ZephyrCloudNine/kinematic_outfits/README.md

# kinematic_dress_hw_fw
Project files for custom "kinematic" dress that uses servos to move parts of it in a wavy motion.
Firmware uses an ESP32-C3 Devkit module.
Servos used - SG90 along with PCA9685 servo driver to extend servo drive functionality.
Mechanical design done on Fusion 360.
