ZephyrCloudNine/kinematic_outfits/hardware/stm32_servo_controller/production/stm32_servo_controller_pcb_BOM_final.xlsx

Designator | Footprint | Quantity | Value | LCSC Part # | JLC assembly type
C1, C10, C11, C18, C21, C22, C5, C6, C7, C9 | 603 | 10 | 100nF | C14663 | Basic
C12, C13 | 1206 | 2 | 22uF | C12891 | Basic
C14, C15, C2, C8 | 603 | 4 | 1uF | C15849 | Basic
C16 | 805 | 1 | 10uF | C15850 | Basic
C17, C19, C20 | 805 | 3 | 22uF | C45783 | Basic
C3, C4 | 603 | 2 | 20pF | C325469 | Basic
D1, D4 | 603 | 2 | LED_ORANGE | C2286 | Basic
D2, D5 | 603 | 2 | LED_GREEN | C2290 | Basic
D3 | D_SMB | 1 | SS54 | C22452 | Basic
F1 | 1206 | 1 | Polyfuse | C516068 | Extended
FB1 | 805 | 1 | FerriteBead | C79382 | Extended
J3 | GCT_USB4105GFA120 | 1 | USB4105GFA120 | C2988369 | Extended
L1 | L_Sunlord_MWSA0503S | 1 | 6.8uH | C177249 | Extended
L2 | L_Sunlord_MWSA0503S | 1 | 2.2uH | C177247 | Extended
Q1 | SOT-23 | 1 | AO3415A | C133233 | Extended
R1, R2, R20, R28, R3, R4, R8, R9 | 603 | 8 | 10K | C25804 | Basic
R10, R14, R15, R5 | 603 | 4 | 5.1K | C23186 | Basic
R11 | 603 | 1 | 1.5K | C22843 | Basic
R12, R13, R19, R21, R23 | 603 | 5 | 100R | C22775 | Basic
R17 | 603 | 1 | 110K | C25805 | Extended
R18 | 603 | 1 | 15K | C22809 | Basic
R22 | 603 | 1 | 51K | C23196 | Basic
R25, R26 | 603 | 2 | 1K | C21190 | Basic
R27 | 805 | 1 | 0.5R | C28319 | Basic
R6, R7 | 603 | 2 | 22R | C23345 | Basic
U1 | LQFP-48_7x7mm_P0.5mm | 1 | STM32F103C8Tx | C8734 | Extended
U2 | SOT-23-6 | 1 | USBLC6-2SC6 | C5180249 | Extended
U3 | SOT-23-6 | 1 | MT3608B | C19189893 | Extended
U4 | SOT-23-5 | 1 | LP5907MFX-3.3/NOPB | C80670 | Extended
U5 | HSOP-8-1EP_3.9x4.9mm_P1.27mm_EP2.3x2.3mm | 1 | IP2312 | C605433 | Extended
U6 | SOT-23-6 | 1 | DW01 | C227441 | Extended
U7 | TSSOP-8_4.4x3mm_P0.65mm | 1 | HL 8205A | C7499846 | Extended
U8 | TSSOP-20_4.4x6.5mm_P0.65mm | 1 | TXS0108EPW | C17206 | Extended
Y1 | Crystal_HC49-4H | 1 | 8MHz | C21263 | Extended
