ZephyrCloudNine/kinematic_outfits/hardware/stm32_servo_controller/3dmodels/USB4105GFA120.step

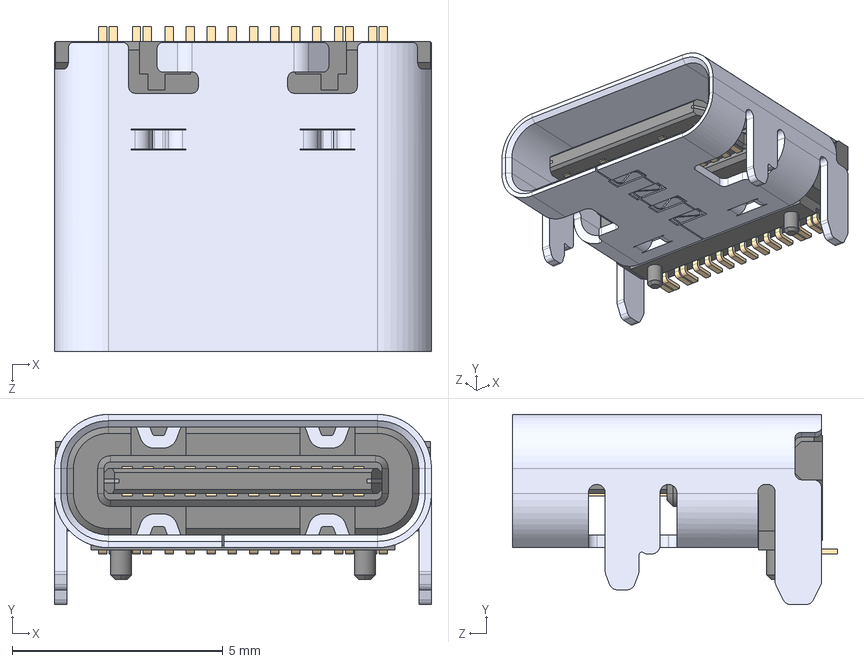
[picture p1: CAD file, 2024-10-18]
hardware/stm32_servo_controller/3dmodels/USB4105GFA120.step
8.94 x 4.51 x 7.71 mm
