ZephyrCloudNine/kinematic_outfits/hardware/stm32_servo_controller/stm32_servo_controller.kicad_pcb

## KiCad design hardware/stm32_servo_controller/stm32_servo_controller.kicad_pcb (2024-11-01)

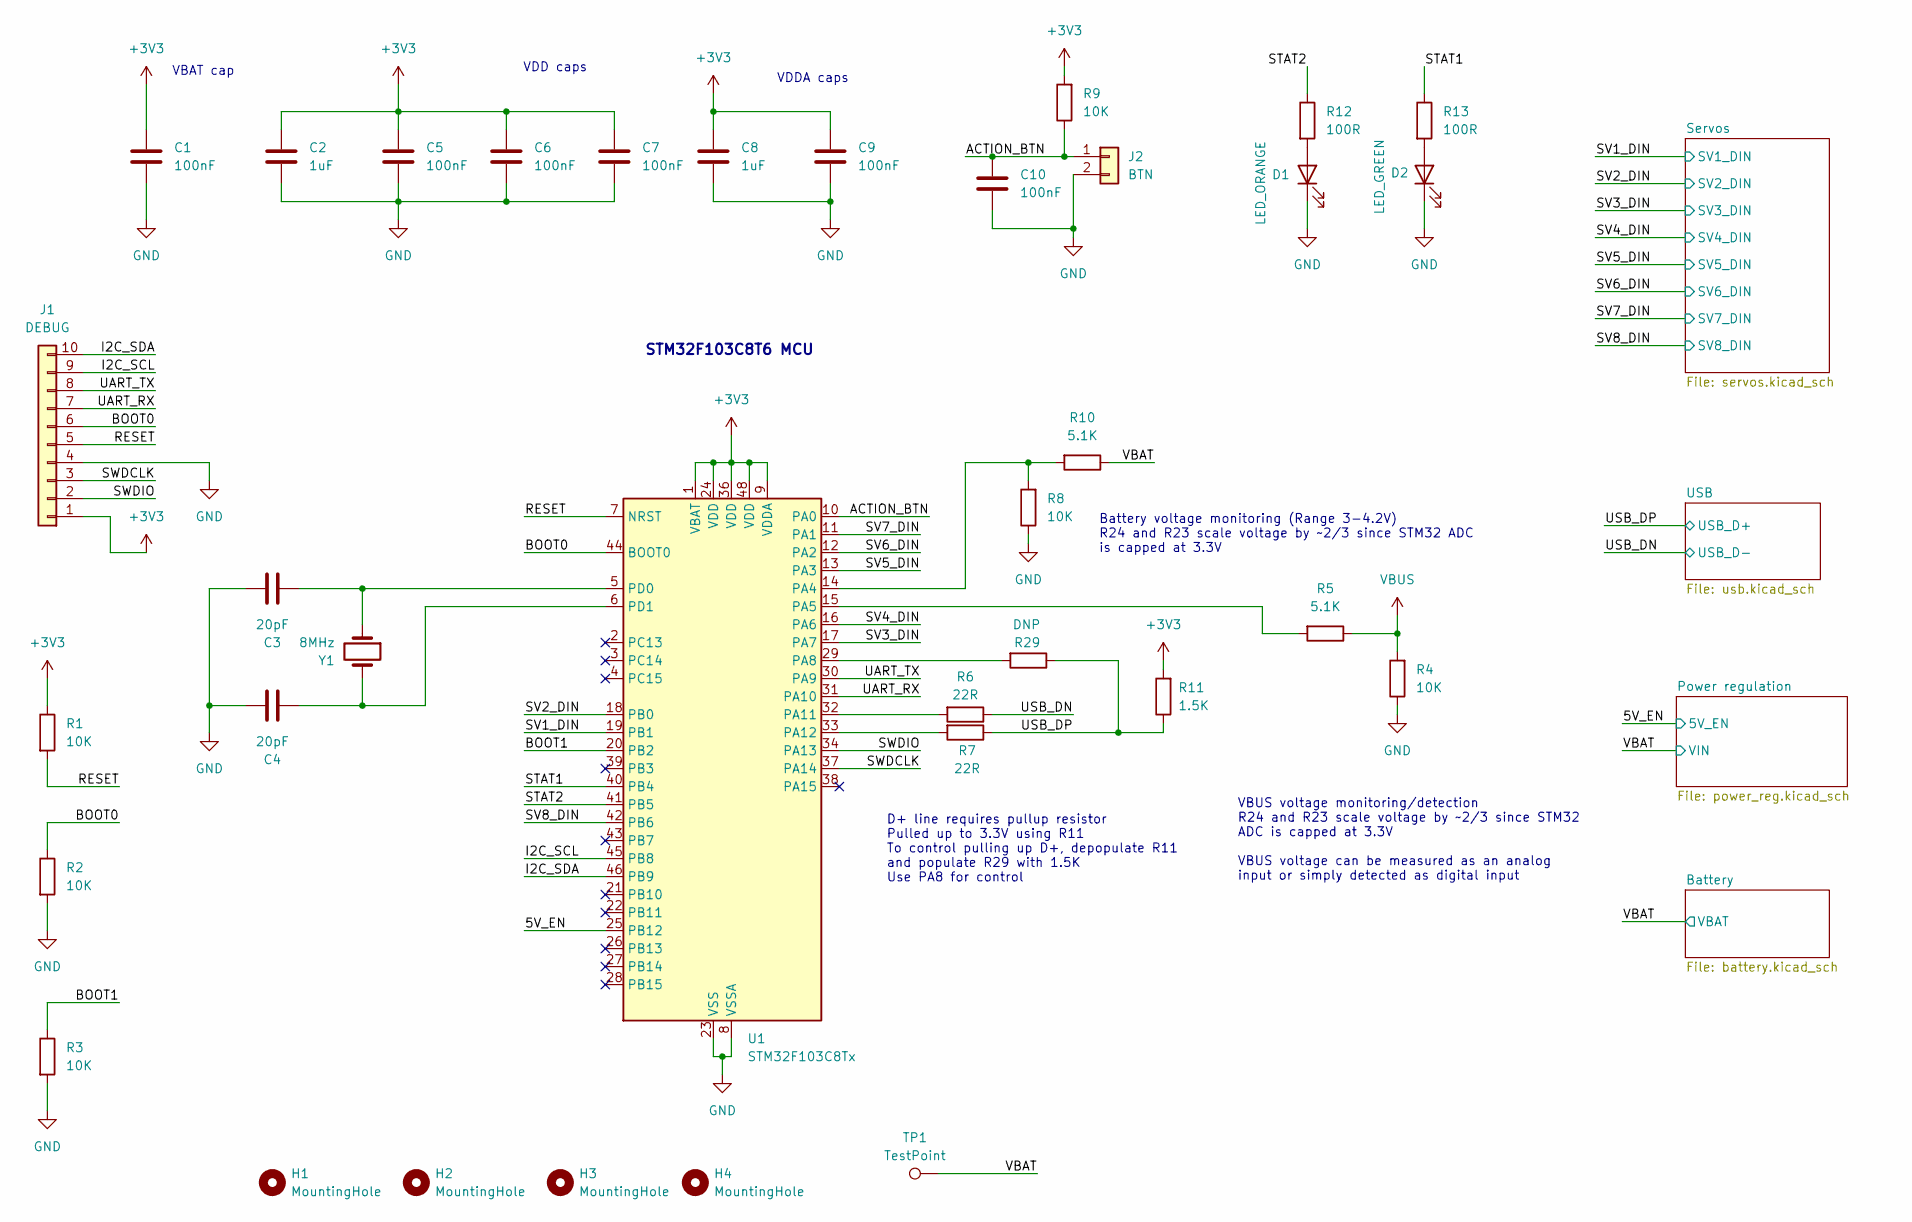
[picture p2: schematic stm32_servo_controller.kicad_sch]

Parts:
C1, C5, C6, C7, C9, C10: 100nF; C_0603_1608Metric
C2, C8: 1uF; C_0603_1608Metric
C3, C4: 20pF; C_0603_1608Metric
D1: LED_ORANGE; LED_0603_1608Metric
D2: LED_GREEN; LED_0603_1608Metric
H1, H2, H3, H4: MountingHole; MountingHole_3.2mm_M3
J1: DEBUG; PinHeader_1x10_P2.54mm_Vertical
J2: BTN; PinHeader_1x02_P2.54mm_Vertical
R1, R2, R3, R4, R8, R9: 10K; R_0603_1608Metric
R5, R10: 5.1K; R_0603_1608Metric
R6, R7: 22R; R_0603_1608Metric
R11: 1.5K; R_0603_1608Metric
R12, R13: 100R; R_0603_1608Metric
R29: DNP; R_0603_1608Metric
TP1: TestPoint; TestPoint_Pad_D1.0mm
U1: STM32F103C8Tx; LQFP-48_7x7mm_P0.5mm
Y1: 8MHz; Crystal_HC49-4H_Vertical

Connections:
+3V3: C1.1, C2.1, C5.1, C6.1, C7.1, C8.1, C9.1, J1.1, R1.1, R9.2, R11.2, U1.1 (VBAT), U1.9 (VDDA), U1.24 (VDD), U1.36 (VDD), U1.48 (VDD); also elsewhere on the board
/5V_EN: U1.25 (PB12); also elsewhere on the board
/ACTION_BTN: C10.1, J2.1, R9.1, U1.10 (PA0)
/BOOT0: J1.6, R2.1, U1.44 (BOOT0)
/BOOT1: R3.1, U1.20 (PB2)
/I2C_SCL: J1.9, U1.45 (PB8)
/I2C_SDA: J1.10, U1.46 (PB9)
/RESET: J1.5, R1.2, U1.7 (NRST)
/STAT1: R13.1, U1.40 (PB4)
/STAT2: R12.1, U1.41 (PB5)
/SV1_DIN: U1.19 (PB1); also elsewhere on the board
/SV2_DIN: U1.18 (PB0); also elsewhere on the board
/SV3_DIN: U1.17 (PA7); also elsewhere on the board
/SV4_DIN: U1.16 (PA6); also elsewhere on the board
/SV5_DIN: U1.13 (PA3); also elsewhere on the board
/SV6_DIN: U1.12 (PA2); also elsewhere on the board
/SV7_DIN: U1.11 (PA1); also elsewhere on the board
/SV8_DIN: U1.42 (PB6); also elsewhere on the board
/SWDCLK: J1.3, U1.37 (PA14)
/SWDIO: J1.2, U1.34 (PA13)
/UART_RX: J1.7, U1.31 (PA10)
/UART_TX: J1.8, U1.30 (PA9)
/USB_DN: R6.1; also elsewhere on the board
/USB_DP: R7.1, R11.1, R29.1; also elsewhere on the board
/VBAT: R10.1, TP1.1; also elsewhere on the board
GND: C1.2, C2.2, C3.2, C4.2, C5.2, C6.2, C7.2, C8.2, C9.2, C10.2, D1.1 (K), D2.1 (K), J1.4, J2.2, R2.2, R3.2, R4.1, R8.1, U1.8 (VSSA), U1.23 (VSS), U1.35 (VSS), U1.47 (VSS); also elsewhere on the board
unnamed: D1.2 (A), R12.2
unnamed: D2.2 (A), R13.2
unnamed: R8.2, R10.2, U1.14 (PA4)
unnamed: R5.2, U1.15 (PA5)
unnamed: R29.2, U1.29 (PA8)
unnamed: R6.2, U1.32 (PA11)
unnamed: R7.2, U1.33 (PA12)
unnamed: C3.1, U1.5 (PD0), Y1.1
unnamed: C4.1, U1.6 (PD1), Y1.2
VBUS: R4.2, R5.1; also elsewhere on the board

Notes on the sheet:
STM32F103C8T6 MCU
VDDA caps
VBAT cap
VDD caps
D+ line requires pullup resistor Pulled up to 3.3V using R11 To control pulling up D+, depopulate R11 and populate R29 with 1.5K Use PA8 for control
VBUS voltage monitoring/detection R24 and R23 scale voltage by ~2/3 since STM32 ADC is capped at 3.3V VBUS voltage can be measured as an analog input or simply detected as digital input
Battery voltage monitoring (Range 3-4.2V) R24 and R23 scale voltage by ~2/3 since STM32 ADC is capped at 3.3V

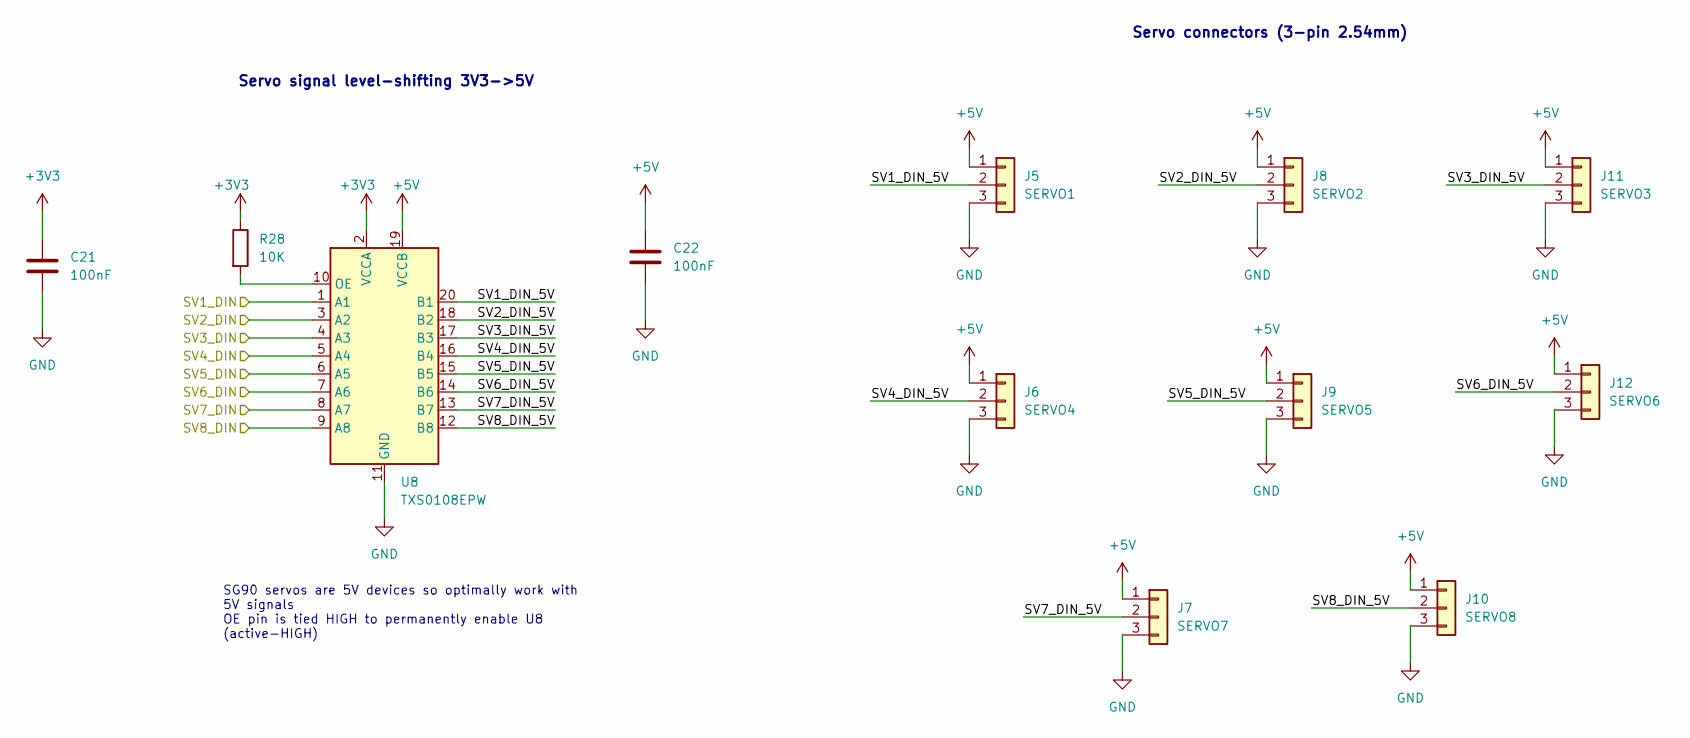
[picture p3: schematic servos.kicad_sch]

Parts:
C21, C22: 100nF; C_0603_1608Metric
J5: SERVO1; JST_XH_B3B-XH-A_1x03_P2.50mm_Vertical
J6: SERVO4; JST_XH_B3B-XH-A_1x03_P2.50mm_Vertical
J7: SERVO7; JST_XH_B3B-XH-A_1x03_P2.50mm_Vertical
J8: SERVO2; JST_XH_B3B-XH-A_1x03_P2.50mm_Vertical
J9: SERVO5; JST_XH_B3B-XH-A_1x03_P2.50mm_Vertical
J10: SERVO8; JST_XH_B3B-XH-A_1x03_P2.50mm_Vertical
J11: SERVO3; JST_XH_B3B-XH-A_1x03_P2.50mm_Vertical
J12: SERVO6; JST_XH_B3B-XH-A_1x03_P2.50mm_Vertical
R28: 10K; R_0603_1608Metric
U8: TXS0108EPW; TSSOP-20_4.4x6.5mm_P0.65mm

Connections:
+3V3: C21.1, R28.1, U8.2 (VCCA); also elsewhere on the board
+5V: C22.1, J5.1, J6.1, J7.1, J8.1, J9.1, J10.1, J11.1, J12.1, U8.19 (VCCB); also elsewhere on the board
/SV1_DIN: U8.1 (A1); also elsewhere on the board
/SV2_DIN: U8.3 (A2); also elsewhere on the board
/SV3_DIN: U8.4 (A3); also elsewhere on the board
/SV4_DIN: U8.5 (A4); also elsewhere on the board
/SV5_DIN: U8.6 (A5); also elsewhere on the board
/SV6_DIN: U8.7 (A6); also elsewhere on the board
/SV7_DIN: U8.8 (A7); also elsewhere on the board
/SV8_DIN: U8.9 (A8); also elsewhere on the board
/Servos/SV1_DIN_5V: J5.2, U8.20 (B1)
/Servos/SV2_DIN_5V: J8.2, U8.18 (B2)
/Servos/SV3_DIN_5V: J11.2, U8.17 (B3)
/Servos/SV4_DIN_5V: J6.2, U8.16 (B4)
/Servos/SV5_DIN_5V: J9.2, U8.15 (B5)
/Servos/SV6_DIN_5V: J12.2, U8.14 (B6)
/Servos/SV7_DIN_5V: J7.2, U8.13 (B7)
/Servos/SV8_DIN_5V: J10.2, U8.12 (B8)
GND: C21.2, C22.2, J5.3, J6.3, J7.3, J8.3, J9.3, J10.3, J11.3, J12.3, U8.11 (GND); also elsewhere on the board
unnamed: R28.2, U8.10 (OE)

Notes on the sheet:
Servo signal level-shifting 3V3->5V
SG90 servos are 5V devices so optimally work with 5V signals OE pin is tied HIGH to permanently enable U8 (active-HIGH)
Servo connectors (3-pin 2.54mm)

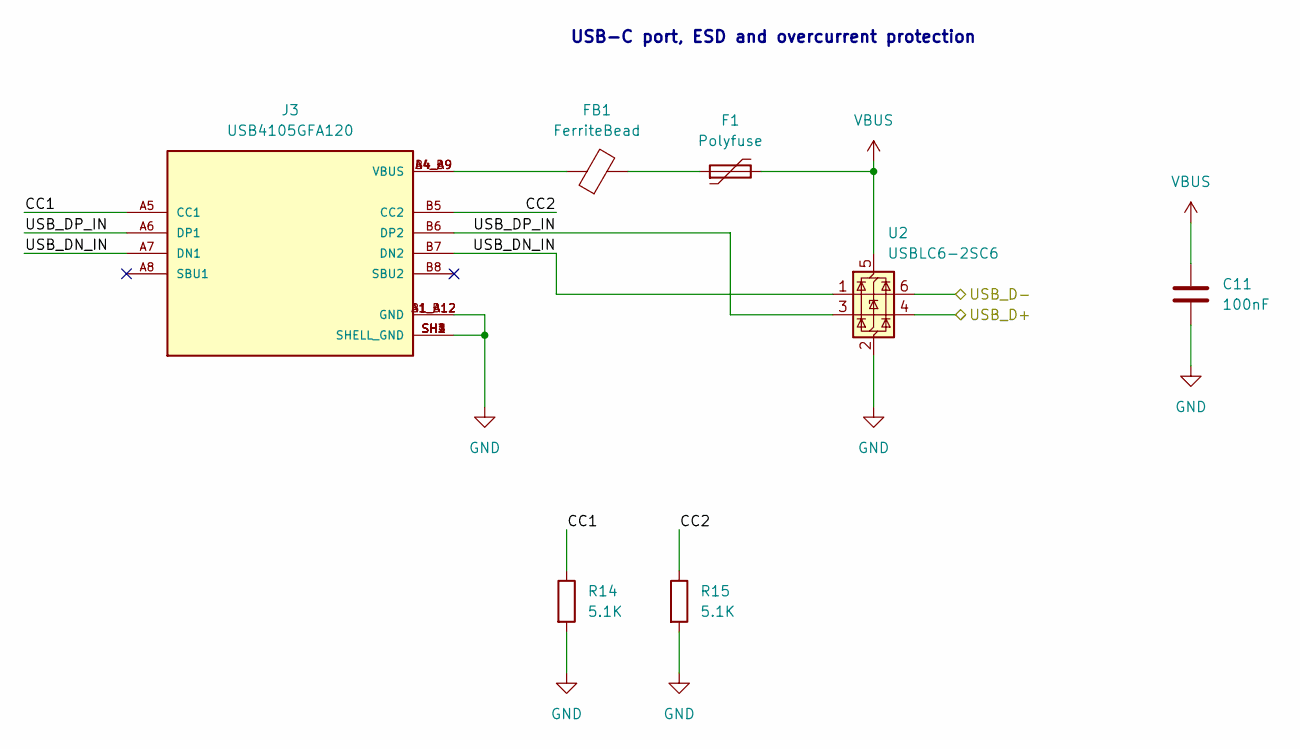
[picture p4: schematic usb.kicad_sch]

Parts:
C11: 100nF; C_0603_1608Metric
F1: Polyfuse; Fuse_1206_3216Metric
FB1: FerriteBead; L_0805_2012Metric
J3: USB4105GFA120; GCT_USB4105GFA120; PARTREV B3
R14, R15: 5.1K; R_0603_1608Metric
U2: USBLC6-2SC6; SOT-23-6

Connections:
/USB/CC1: J3.A5 (CC1), R14.1
/USB/CC2: J3.B5 (CC2), R15.1
/USB/USB_DN_IN: J3.A7 (DN1), J3.B7 (DN2), U2.1 (I/O1)
/USB/USB_DP_IN: J3.A6 (DP1), J3.B6 (DP2), U2.3 (I/O2)
/USB_DN: U2.6 (I/O1); also elsewhere on the board
/USB_DP: U2.4 (I/O2); also elsewhere on the board
GND: C11.2, J3.A1_B12 (GND), J3.B1_A12 (GND), J3.SH1 (SHELL_GND), J3.SH2 (SHELL_GND), J3.SH3 (SHELL_GND), J3.SH4 (SHELL_GND), R14.2, R15.2, U2.2 (GND); also elsewhere on the board
unnamed: F1.1, FB1.2
unnamed: FB1.1, J3.A4_B9 (VBUS), J3.B4_A9 (VBUS)
VBUS: C11.1, F1.2, U2.5 (VBUS); also elsewhere on the board

Notes on the sheet:
USB-C port, ESD and overcurrent protection

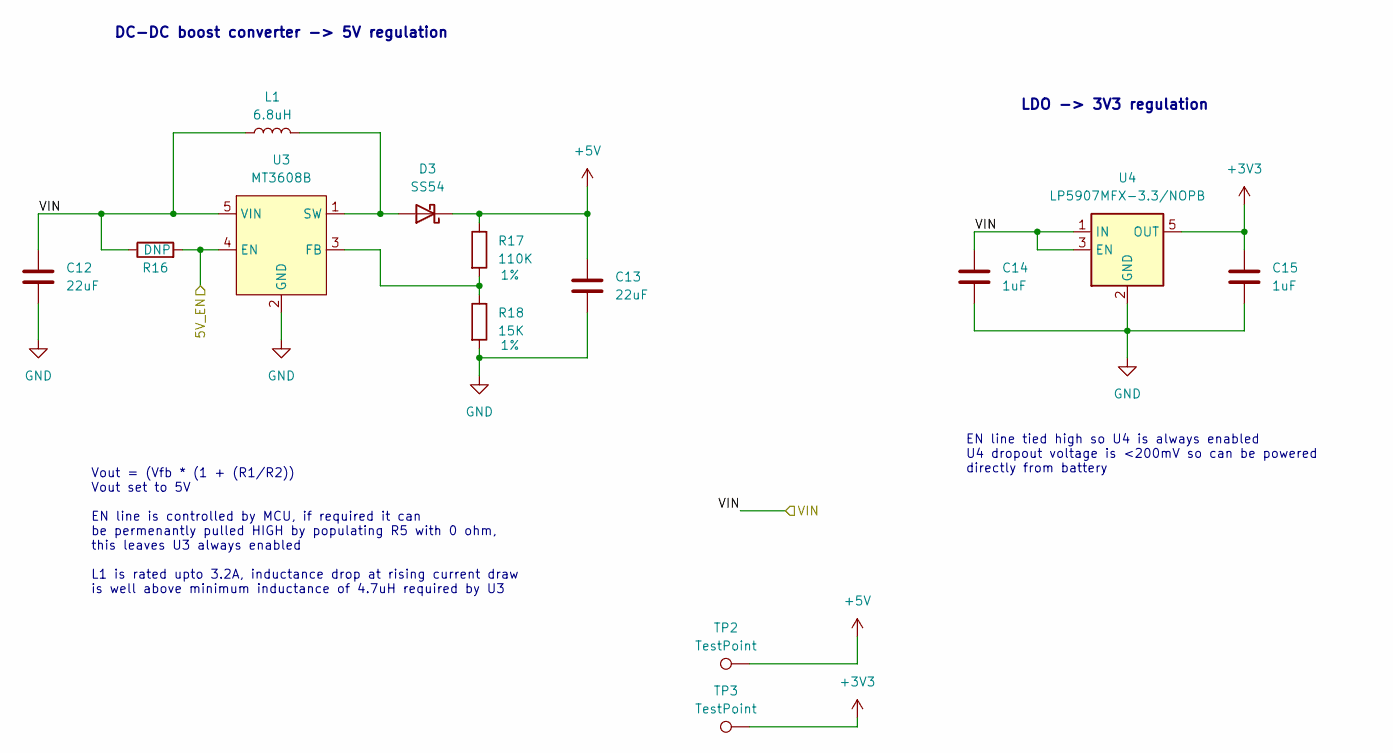
[picture p5: schematic power_reg.kicad_sch]

Parts:
C12, C13: 22uF; C_1206_3216Metric
C14, C15: 1uF; C_0603_1608Metric
D3: SS54; D_SMB
L1: 6.8uH; L_Sunlord_MWSA0503S
R16: DNP; R_0603_1608Metric
R17: 110K; R_0603_1608Metric; Tolerance 1%
R18: 15K; R_0603_1608Metric; Tolerance 1%
TP2, TP3: TestPoint; TestPoint_Pad_D1.0mm
U3: MT3608B; SOT-23-6
U4: LP5907MFX-3.3/NOPB; SOT-23-5

Connections:
+3V3: C15.1, TP3.1, U4.5 (OUT); also elsewhere on the board
+5V: C13.1, D3.1 (K), R17.1, TP2.1; also elsewhere on the board
/5V_EN: R16.2, U3.4 (EN); also elsewhere on the board
/VBAT: C12.1, C14.1, L1.1, R16.1, U3.5 (VIN), U4.1 (IN), U4.3 (EN); also elsewhere on the board
GND: C12.2, C13.2, C14.2, C15.2, R18.2, U3.2 (GND), U4.2 (GND); also elsewhere on the board
unnamed: D3.2 (A), L1.2, U3.1 (SW)
unnamed: R17.2, R18.1, U3.3 (FB)

Notes on the sheet:
DC-DC boost converter -> 5V regulation
Vout = (Vfb * (1 + (R1/R2)) Vout set to 5V EN line is controlled by MCU, if required it can be permenantly pulled HIGH by populating R5 with 0 ohm, this leaves U3 always enabled L1 is rated upto 3.2A, inductance drop at rising current draw is well above minimum inductance of 4.7uH required by U3
LDO -> 3V3 regulation
EN line tied high so U4 is always enabled U4 dropout voltage is <200mV so can be powered directly from battery

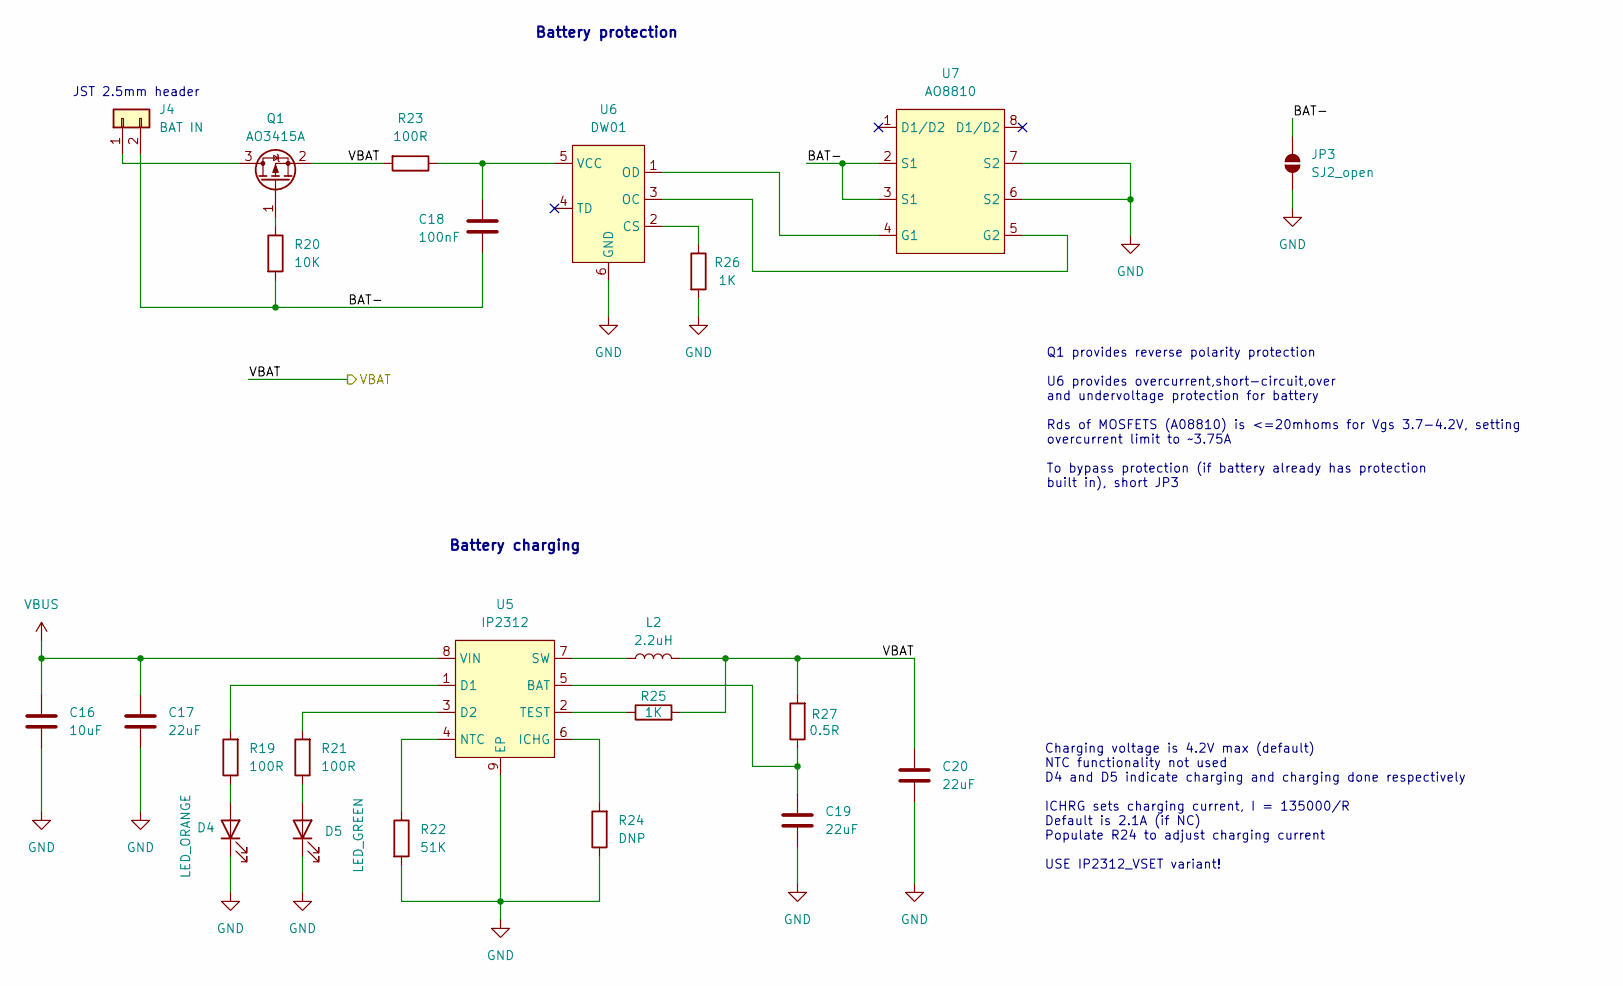
[picture p6: schematic battery.kicad_sch]

Parts:
C16: 10uF; C_0805_2012Metric
C17, C19, C20: 22uF; C_0805_2012Metric
C18: 100nF; C_0603_1608Metric
D4: LED_ORANGE; LED_0603_1608Metric
D5: LED_GREEN; LED_0603_1608Metric
J4: BAT IN; PinHeader_1x02_P2.54mm_Vertical
JP3: SJ2_open; SolderJumper-2_P1.3mm_Open_RoundedPad1.0x1.5mm
L2: 2.2uH; L_Sunlord_MWSA0503S
Q1: AO3415A; SOT-23
R19, R21, R23: 100R; R_0603_1608Metric
R20: 10K; R_0603_1608Metric
R22: 51K; R_0603_1608Metric
R24: DNP; R_0805_2012Metric
R25, R26: 1K; R_0603_1608Metric
R27: 0.5R; R_0805_2012Metric
U5: IP2312; HSOP-8-1EP_3.9x4.9mm_P1.27mm_EP2.3x2.3mm
U6: DW01; SOT-23-6
U7: AO8810; TSSOP-8_4.4x3mm_P0.65mm

Connections:
/Battery/BAT-: C18.2, J4.2, JP3.2 (B), R20.2, U7.2 (S1), U7.3 (S1)
/VBAT: C20.1, L2.2, Q1.2 (S), R23.2, R25.2, R27.2; also elsewhere on the board
GND: C16.2, C17.2, C19.2, C20.2, D4.1 (K), D5.1 (K), JP3.1 (A), R22.2, R24.1, R26.2, U5.9 (EP), U6.6 (GND), U7.6 (S2), U7.7 (S2); also elsewhere on the board
unnamed: D4.2 (A), R19.1
unnamed: D5.2 (A), R21.1
unnamed: J4.1, Q1.3 (D)
unnamed: Q1.1 (G), R20.1
unnamed: C19.1, R27.1, U5.5 (BAT)
unnamed: R19.2, U5.1 (D1)
unnamed: R21.2, U5.3 (D2)
unnamed: R24.2, U5.6 (ICHG)
unnamed: R22.1, U5.4 (NTC)
unnamed: L2.1, U5.7 (SW)
unnamed: R25.1, U5.2 (TEST)
unnamed: R26.1, U6.2 (CS)
unnamed: U6.3 (OC), U7.5 (G2)
unnamed: U6.1 (OD), U7.4 (G1)
unnamed: C18.1, R23.1, U6.5 (VCC)
VBUS: C16.1, C17.1, U5.8 (VIN); also elsewhere on the board

Notes on the sheet:
Charging voltage is 4.2V max (default) NTC functionality not used D4 and D5 indicate charging and charging done respectively ICHRG sets charging current, I = 135000/R Default is 2.1A (if NC) Populate R24 to adjust charging current USE IP2312_VSET variant!
Battery charging
JST 2.5mm header
Battery protection
Q1 provides reverse polarity protection U6 provides overcurrent,short-circuit,over and undervoltage protection for battery Rds of MOSFETS (A08810) is <=20mhoms for Vgs 3.7-4.2V, setting overcurrent limit to ~3.75A To bypass protection (if battery already has protection built in), short JP3

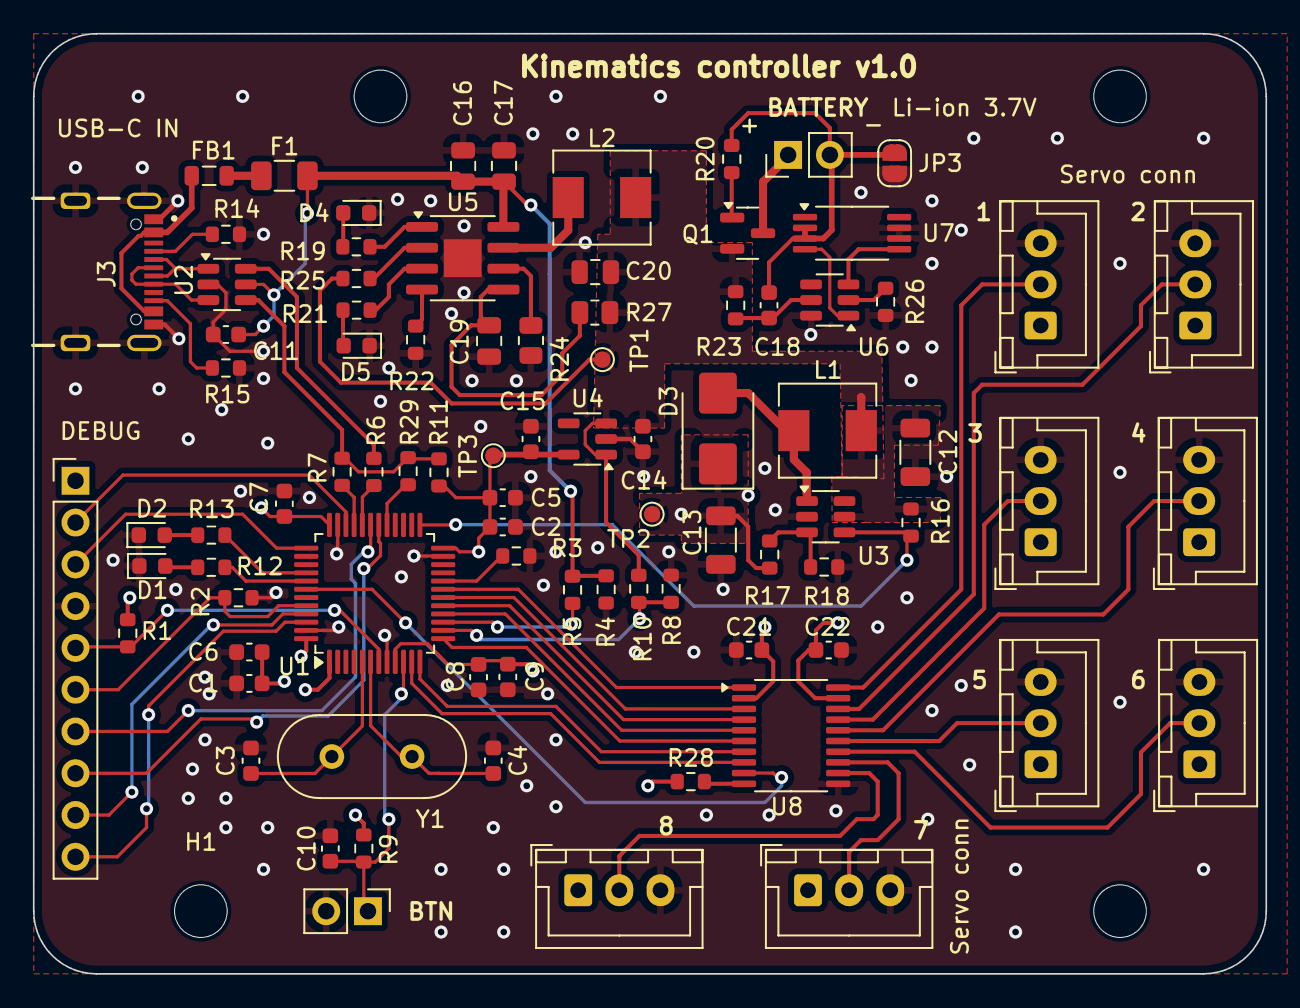
[picture p7: board stm32_servo_controller.kicad_pcb from above]

Board: 4 copper layers, 74.9 x 57.1 mm, 90 parts (0 on the bottom side), 70 nets.
