ZephyrCloudNine/kinematic_outfits/firmware/controller_fw/pinouts.h

#ifndef PINOUTS_H
#define PINOUTS_H

//ADC pins
#define VBUS_MON PA5
#define VBAT_MON PA4

//button GPIO
#define ACTION_BTN PA0

//Status LED GPIO's
#define STAT1_LED PB4
#define STAT2_LED PB5

//Boost conv 5V enable
#define _5V_EN PB12

//I2C interfacce
#define I2C_SDA B9
#define I2C_SCL PB8

//servo outputs
#define SV1_DOUT PB1
#define SV2_DOUT PB0
#define SV3_DOUT PA7
#define SV4_DOUT PA6
#define SV5_DOUT PA3
#define SV6_DOUT PA2
#define SV7_DOUT PA1
#define SV8_DOUT PB6

#endif
