ZephyrCloudNine/kinematic_outfits/(commit log)

2024-05-21 init code to test servo on PCA9685
2024-05-21 test code to run 4x servos on any of the 2 PCA9685 drivers
2024-05-21 added FastLED code to control on-board RGB LED on ESP32C3-Devkit
2024-05-22 added function to manually tune each servo and parses Serial input -required to correctly assemble each servo unit -command is in string format: driver_id, channel_id, pulse_length
2024-05-27 WIP test FW 240524 -successful test demo of 7 servos fitted onto dress
2024-06-11 FW ver 20240611 -15 motors running asynchronously
2024-10-12 updated file structure -added seperate folders for firmware and hardware -added KICAD project folder for servo_controller PCB design -added gitignore
    [stm32_servo_controller.kicad_pcb, stm32_servo_controller.kicad_sch]
2024-10-18 STM32 servo controller PCB KICAD project files
    -STM32F103CT8G MCU
    -Battery protection and charging circuitry on-board (1S1P/2P) Li-ion
    -5V DC-DC converter and 3.3V regulation
    -8x outputs for controlling upto 8 servo motors (SG90, etc ) using 2.5mm 3 pin headers/connectors
    -SWD, UART and I2C ports broken out on 2.54mm headers
    -USB-C input for charging and USB device functionality on STM32
    -External button functionality for custom actions/functions
    [USB4105GFA120.step, battery.kicad_sch, bom.csv, designators.csv, positions.csv, power_reg.kicad_sch, servos.kicad_sch, stm32_servo_controller.kicad_pcb]
2024-10-20 updated PCB BOM file
    [stm32_servo_controller_pcb_BOM_final.xlsx]
2024-11-01 Sample test FW setup for PCB rev1
    -added seperate .h for pinout definitions
    -updated all definitions for pins
    -tested LED blinking and USB CDC
    [battery.kicad_sch]
2024-11-01 added ADC functionality
    -tested VBAT and VBUS monitoring
    -added function to derive voltage reading from raw analog reading and resistor divider ratio
2024-11-01 tested servos output block
    -level shifting works as intended
    -PWM write used to test 5V servo outputs switching
2024-11-01 Test FW to check all functionality of rev1 PCB's
2024-11-01 updated test FW
    -added utility.bat to simplify and uploading FW over Arduino CLI
    -added controlling servos (only 2 used for testing)
    -Loop monitors battery voltage and halts servos if low battery
2024-11-11 updated test FW
    [stm32_servo_controller.kicad_pcb]
2024-11-23 FW: added LED flash pattern to indicate controller startup
2024-11-23 added servo configs
2024-11-23 added MillisTimer and PRDCServo_HT to src folder
2024-11-24 modified ServoHT class
    -added setLimits() func to store arbitary lower and upper limits in degrees
    -added readDir() func to determine direction of servo movement
2024-11-24 servo updating now uses soft-timer hence non-blocking. updates at 50Hz
2024-11-24 voltage readings are now done periodically and non-blocking
2024-11-24 added VBUS detection to disable system when it is being charged
2024-11-25 added low battery detection
    -checks VBAT against threshold
    -halts loop if VBAT < threshold
    -flashes red LED periodically for visual indication of low battery
2024-11-26 added macros to configure different device variants while keeping codebase generic
2024-11-26 added time hysteresis to low battery detection to avoid false triggers due to sag/spikes
    [config.h, controller_fw.ino]
2024-11-27 general updates and fixes
    [config.h, controller_fw.ino]
